dratsuni/robo-sumo-autonomo-SENAI/midia/esquema-3d/Copy of V2.png

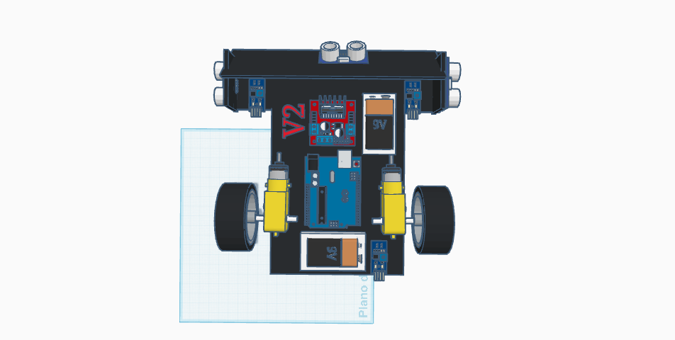
midia/esquema-3d/Copy of V2.png
