dratsuni/robo-sumo-autonomo-SENAI/midia/fluxograma/Funcionamento do Robô.png

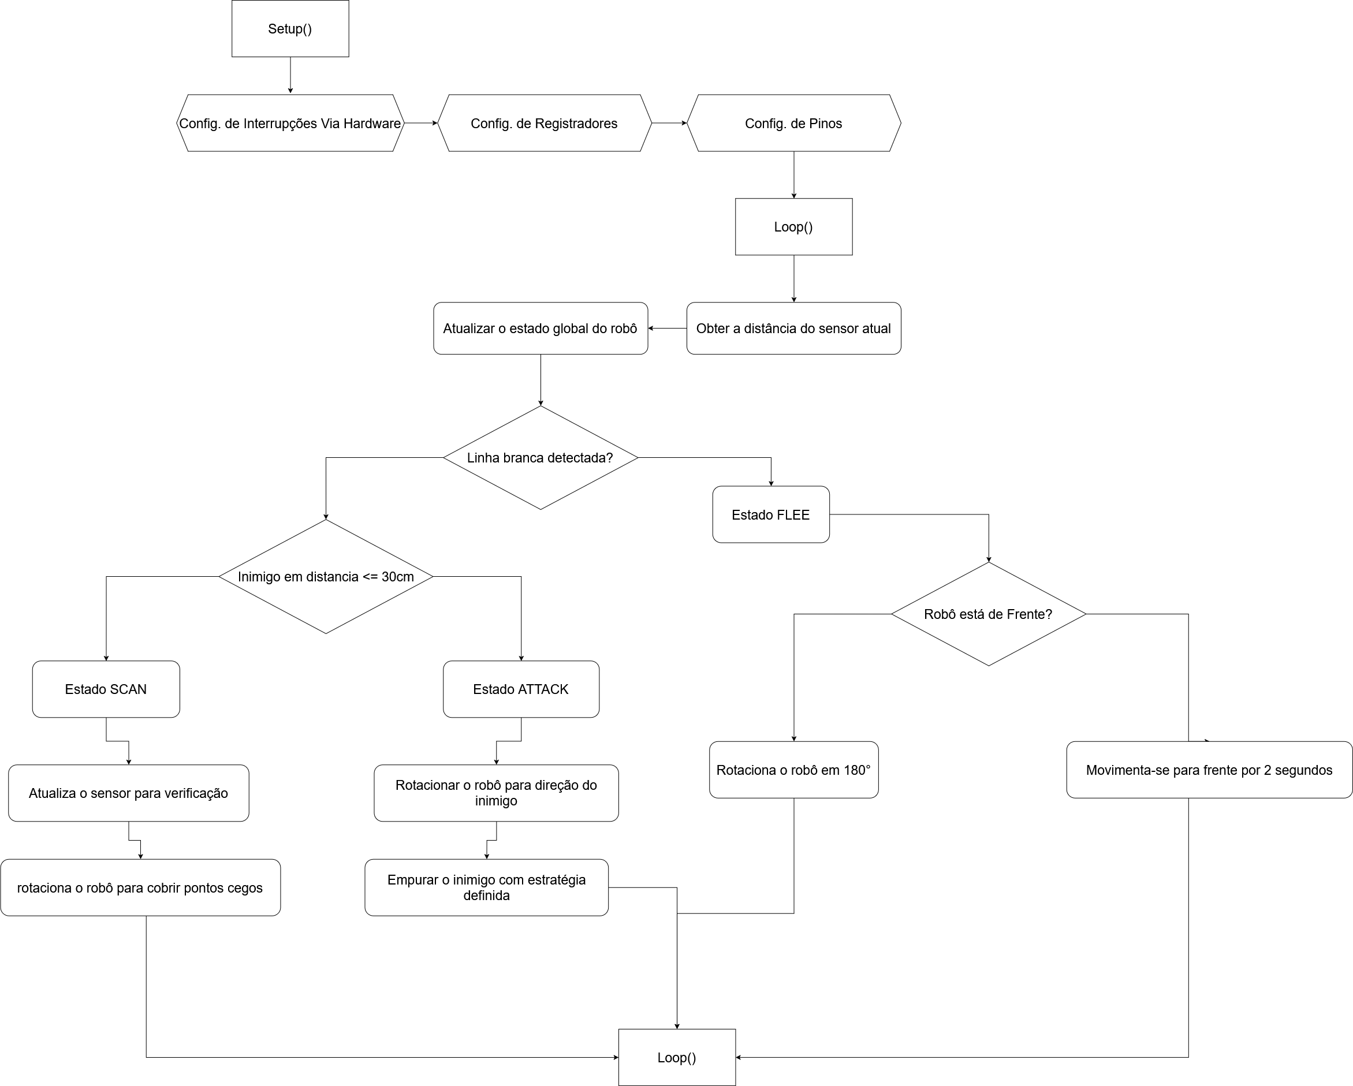
midia/fluxograma/Funcionamento do Robô.png
