dratsuni/robo-sumo-autonomo-SENAI/midia/fotos/V2.jpeg

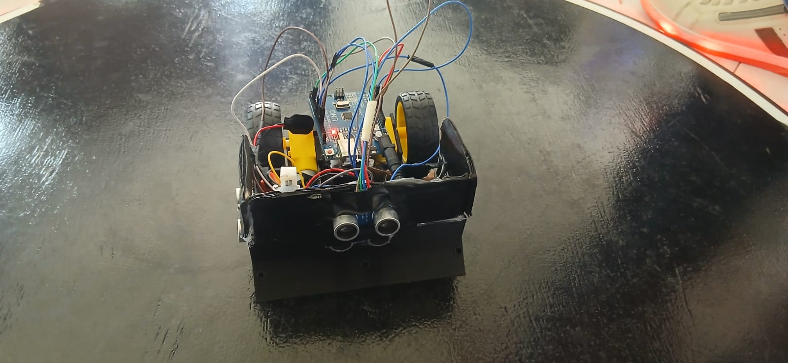
midia/fotos/V2.jpeg
