dratsuni/robo-sumo-autonomo-SENAI/midia/fotos/primeira-montagem.jpeg

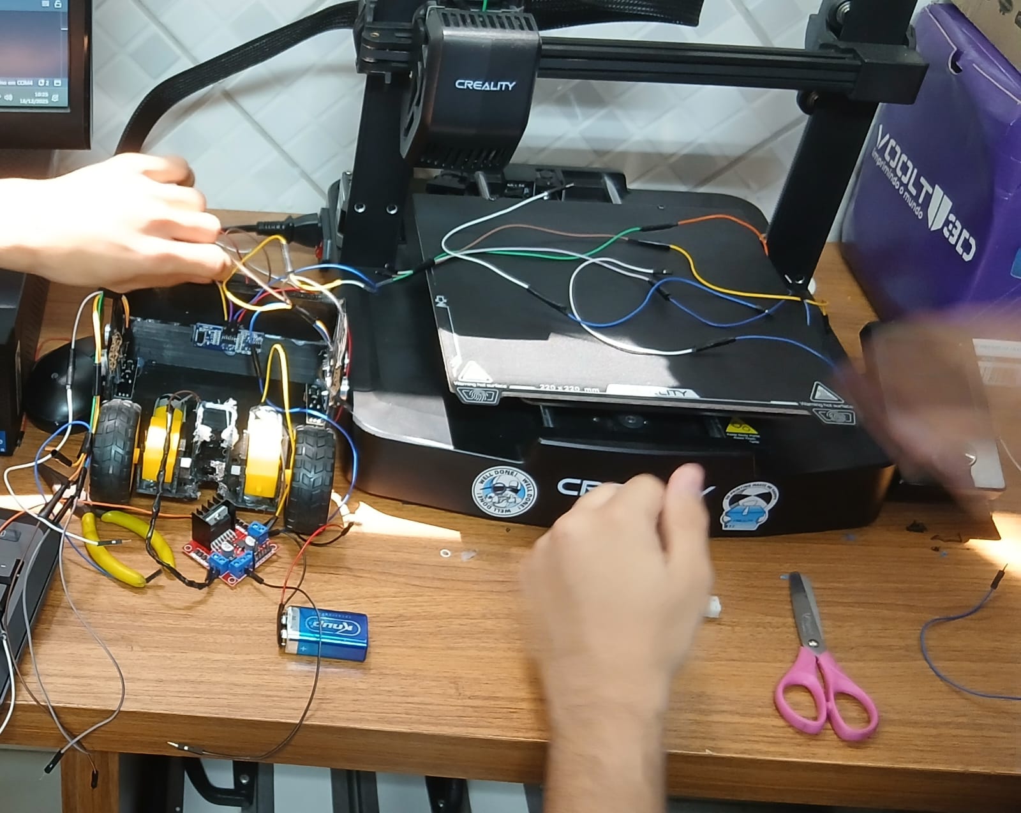
midia/fotos/primeira-montagem.jpeg
