dratsuni/robo-sumo-autonomo-SENAI/midia/fotos/visão-motores-testes.jpeg

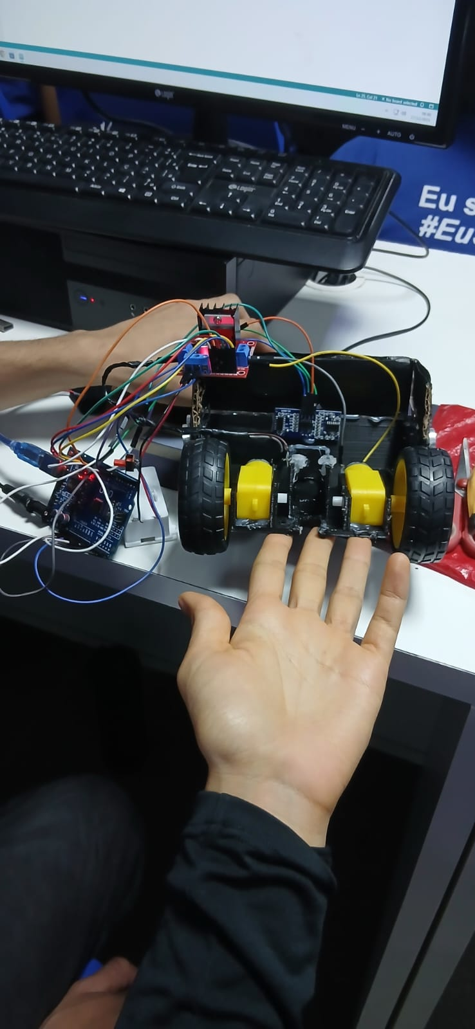
midia/fotos/visão-motores-testes.jpeg
