dratsuni/robo-sumo-autonomo-SENAI/src/motor.cpp

#include <Arduino.h>
#include "../include/motor.h"
#include "../include/pins.h"

static void change_velocity_motor_1(uint8_t velocity);
static void change_velocity_motor_2(uint8_t velocity);

Motor_t g_motor_1 = {IN1_PIN, IN2_PIN, change_velocity_motor_1};
Motor_t g_motor_2 = {IN3_PIN, IN4_PIN, change_velocity_motor_2};

//essas funções muda a velocidade dos motores mudando o valor do registrador OCR1X (diminuindo o intervalo entre os pulsos PWM);
static void change_velocity_motor_1(uint8_t velocity){
  OCR1A = velocity;
}

static void change_velocity_motor_2(uint8_t velocity){
  OCR1B = velocity;
}

//função para mudar o sentido dos motores. Isso controla o estado dos pinos IN1, IN2, IN3 e IN4 da ponte H l298n.
static void change_motor_direction(MotorDirection_t direction, Motor_t *motor){
    switch (direction) {
        case CLOCK_WISE:
          PORTB |= motor->inx_1;
          PORTB &= ~(motor->inx_2);
          break;
        case COUNTER_CLOCK_WISE:
          PORTB |= motor->inx_2;
          PORTB &= ~(motor->inx_1);
          break;
        case STOP:
          PORTB &= ~(motor->inx_1 | motor->inx_2);
          break;
        case BRAKE:
          PORTB |= motor->inx_1 | motor->inx_2;
        default:
          PORTB &= ~(motor->inx_1 | motor->inx_2);
          break;
    }
}

void motor_manager(Motor_t *motor, MotorDirection_t direction, uint8_t velocity){
  motor->motor_velocity_manager(velocity);
  change_motor_direction(direction, motor);
}

void move(Motor_t *motor_1, Motor_t *motor_2, MotorDirection_t direction, uint8_t velocity){
  motor_manager(motor_1, direction, velocity);
  motor_manager(motor_2, direction, velocity);
}

void turn(Motor_t *motor_1, Motor_t *motor_2, MotorDirection_t direction){
  motor_manager(motor_1, direction, 50);
  motor_manager(motor_2, direction, 100);
}

void rotate_axis(Motor_t *motor_1, Motor_t *motor_2, uint8_t velocity){
  motor_manager(motor_1, CLOCK_WISE, velocity);
  motor_manager(motor_2, COUNTER_CLOCK_WISE, velocity);     
}

void turn_to(MovementState_t turn_to ){
  if (turn_to == TURN_RIGHT){
    rotate_axis(&g_motor_1, &g_motor_2, 100);
  } else if (turn_to == TURN_LEFT){
    rotate_axis(&g_motor_2, &g_motor_1, 100);
  }
}

void brake(Motor_t *motor_1, Motor_t *motor_2){
  change_motor_direction(BRAKE, motor_1);
  change_motor_direction(BRAKE, motor_2);
}

void rotate_axis_with_delay(Motor_t *motor_1, Motor_t *motor_2, int velocity, unsigned int delay){
  int initial_millis = millis();
  
  while (millis() - initial_millis <= delay && g_current_robot_state != FLEE) {
    rotate_axis(motor_1, motor_2, velocity);
  }

  brake(motor_1, motor_2);
}
