dratsuni/robo-sumo-autonomo-SENAI/(commit log)

2025-12-12 driver do sensor ultrassonico corrigido. Disparo sequencial adicionado.
    [robo-sumo.ino, ultrasonic_sensor.cpp, ultrasonic_sensor.h]
2025-12-14 driver do sensor ultrassonico modificado. Disparo sequencial foi removido e houve melhorias na logica de disparo.
2025-12-14 driver do sensor ultrassonico modificado. Houve uma diminuição no intervalo. Agora, o sensor será disparado a cada 23 milissegundos
2025-12-14 driver do sensor ultrassonico modificado. Houve uma diminuição no intervalo. Agora, o sensor será disparado a cada 25 milissegundos
2025-12-14 driver do sensor ultrassonico modificado. Adicionado __attribute__((always_inline)) para garantir que a função seja inline.
2025-12-14 init_configs.h para start_configs.h. função start_pins movida para start_configs.h
2025-12-15 mudanças de design ocorreram em todos os drivers.
2025-12-19 Alterações de alguns nomes
2025-12-19 Alguns ajustes de identação e atualização de nome g_current_robot_state em motor.cpp
2025-12-19 Comentarios e algumas mudanças de nomes
2025-12-19 Atualização da função scan() e retorno dos nomes UltrasonicPosition_t position em vez de UltrasonicDirection_t direction, faz mais sentido
2025-12-19 Update README with flowchart and test conclusions
    Added a flowchart and a section for tests and conclusions.
2025-12-19 Revise README with project details and improvements
    Updated the README to include detailed project objectives, components, programming justification, assembly notes, strategy, and testing conclusions.
2025-12-20 add circuito-eletrico.jpg
